marisam2019/ECE411-roomies/ECE 411 - Gantt Chart - Team 8.pdf

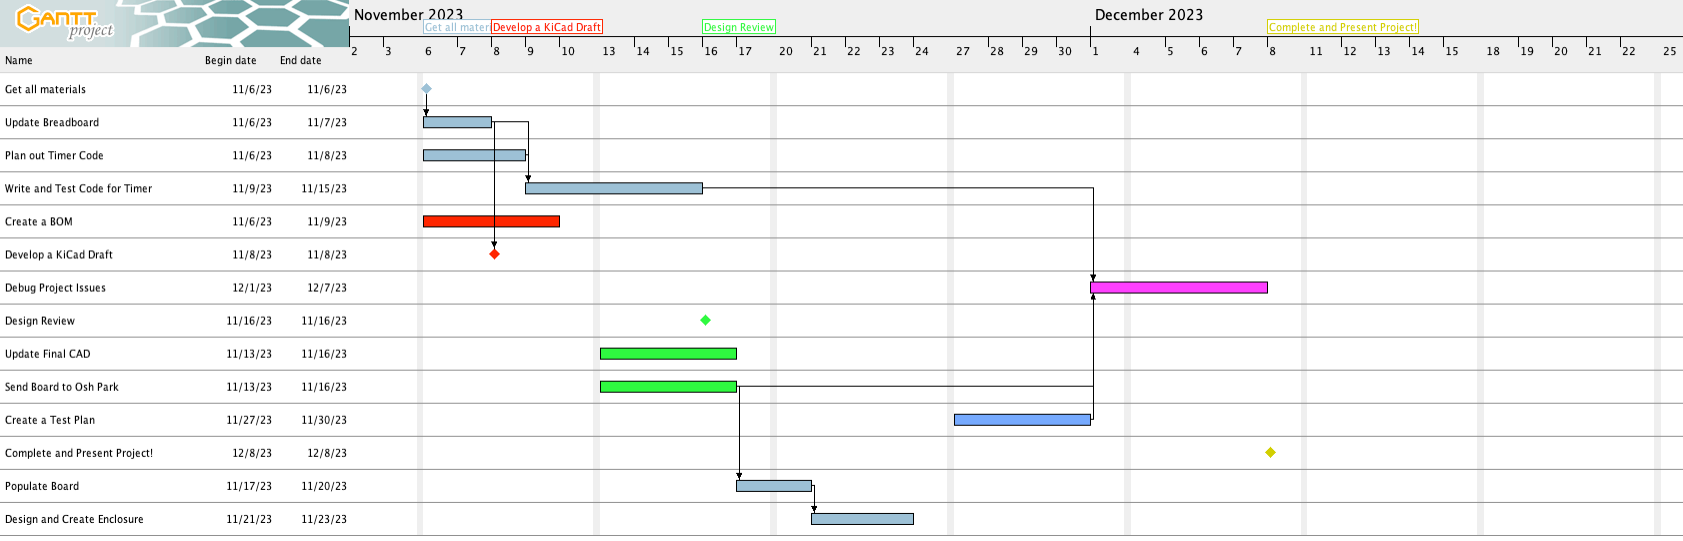
[picture p2: figure]
