marisam2019/ECE411-roomies/9-3.3 voltage divider.png

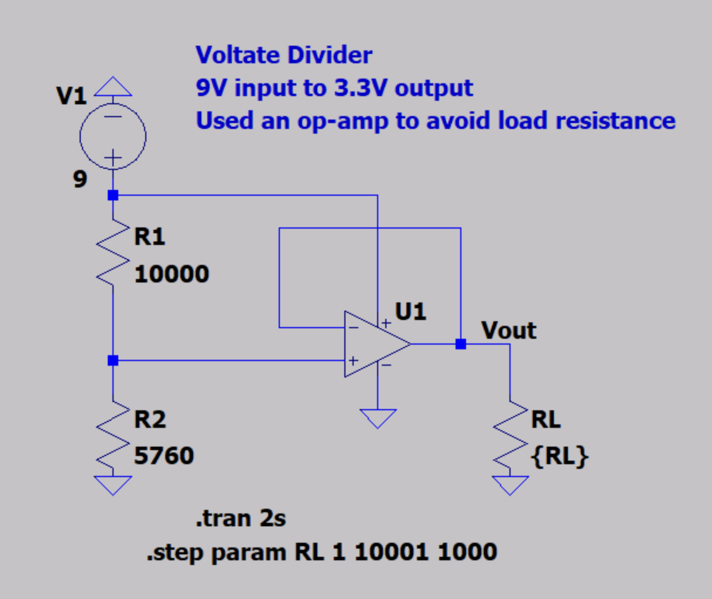
9-3.3 voltage divider.png
