marisam2019/ECE411-roomies/ECE 411 Bill of Materials - Team 8.xlsx

Bill Of Materials for: [TEAM 8] [The Roomies]
Last modified: [11/8/23]
PCB version: [PCB VERSION # 1]
BOM revision: [BOM REVISION #1] |  | P/NP | = Place/Not Place (components marked NP are not stuffed on the board)
Cnt | Part References | P/NP | Mfg | Mfg PN | Description | Dist | Dist Part Number | Cost Ea. | Cost Total
1 | A1 | P | Adafruit Industries LLC | 5477 | Adafruit HUZZAH32 - ESP32 Feather Board | DigiKey | 1528-5477-ND | $22.50 | $22.50
1 | Dis1 | NP | Adafruit Industries LLC | 1002 | Adafruit 0.56" 4-Digit 7-Segment Display w/I2C Backpack - White - STEMMA QT / qwiic | Adafruit Industries LLC | 1002 | $12.95 | $12.95
1 | LinearReg1 | P | Diodes Incorporated | AZ1117IH-3.3TRG1 | ASM Voltage regulator | Digikey | AZ1117IH-3.3TRG1DICT-ND | $0.38 | $0.38
5 | SW2, SW3, SW4, SW5, SW6 | P | Omron Electronics Inc-EMC Div | B3F-1070 | Push Switch | Digikey | SW406-ND | 0.44 | $2.20
1 | D1 | P | Kingbright | WP132XSURDK | 3mm LED Red | Digikey | 754-WP132XSURDK-ND | 0.39 | $0.39
1 | D2 | P | Kingbright | WP132XSYDK | 3mm LED Yellow | Digikey | 754-WP132XSYDK-ND | 0.41 | $0.41
1 | D3 | P | Kingbright | WP132XCGDK | 3mm LED Green | Digikey | 754-WP132XCGDK-ND | 0.39 | $0.39
1 | C1 | P | Nichicon | UKL1H100KDDANATD | CAP ALUM 10UF 20% 50V RADIAL | Digikey | 493-16315-1-ND | 0.34 | $0.34
1 | C2 | P | Murata Electronics | GCJ188R91H104KA01D | CAP CER 0.1UF 50V X8R 0603 | Digikey | 490-14412-1-ND | 0.21 | $0.21
1 | 7SegDisplay1, Rocker_SW_SPST1 | P | Adam Tech | PH1-08-UA | CONN HEADER VERT 8POS 2.54MM | Digikey | 2057-PH1-08-UA-ND | 0.18 | $0.18
1 | BZ1 | P | TDK Corporation | PS1440P02BT | Buzzers Transducer, Externally Driven Piezo 3 V 4kHz 75dB @ 3V, 10cm Through Hole | Digikey | 445-5242-1-ND | 0.78 | $0.78
 |  |  |  |  |  |  |  | TOTAL: | $40.73
VERSION INFO
Rev | Date | Notes
1.0r0 | 2023-11-08 | Initial BOM. Not everything chosen and implemented just yet, lots of things that need to be changed.
