marisam2019/ECE411-roomies/ECE 411 - Updated Schematic - Team8.pdf

## ESP32 Feather

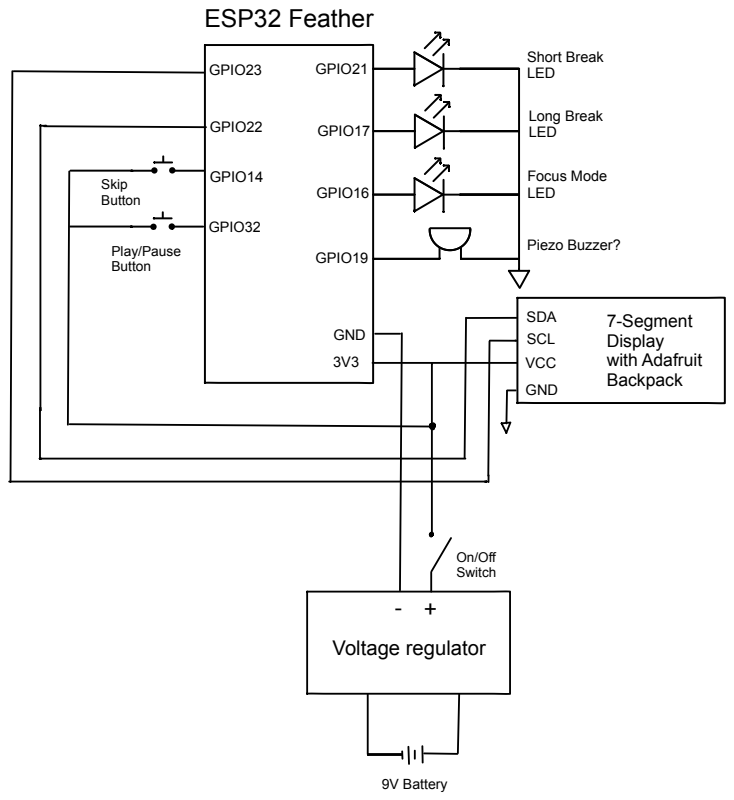
[picture p4: page 1]
9V Battery; On/Off Switch; Play/Pause Button; Skip Button; GPIO23; GPIO21; GND; Short Break LED; Long Break LED; Focus Mode LED; Piezo Buzzer?; GPIO16; GPIO19; GPIO22; VCC; SCL; SDA; GPIO17; 7-Segment Display with Adafruit Backpack; Voltage regulator; GPIO14; GPIO32
