marisam2019/ECE411-roomies/ECE 411 - Schematic - Group 8.pdf

# ESP32

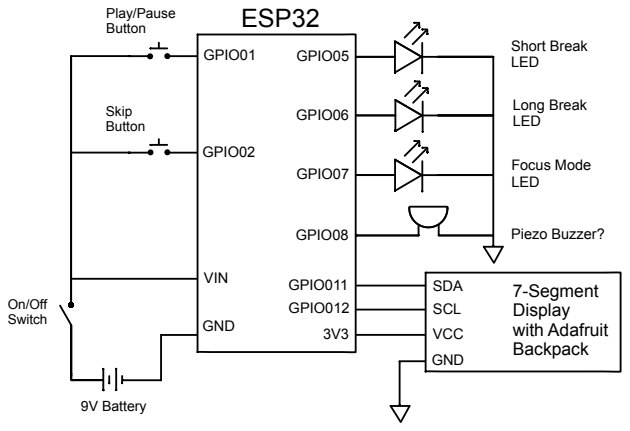
[picture p5: page 1]
9V Battery; On/Off Switch; Play/Pause Button; Skip Button; GPIO01; GPIO02; VIN; GND; Short Break LED; Long Break LED; Focus Mode LED; Piezo Buzzer?; GPIO05; GPIO06; GPIO07; GPIO08; VCC; SCL; GPIO011; SDA; GPIO012; 7-Segment Display with Adafruit Backpack
