marisam2019/ECE411-roomies/Pomodoro_Final_Schematic.pdf

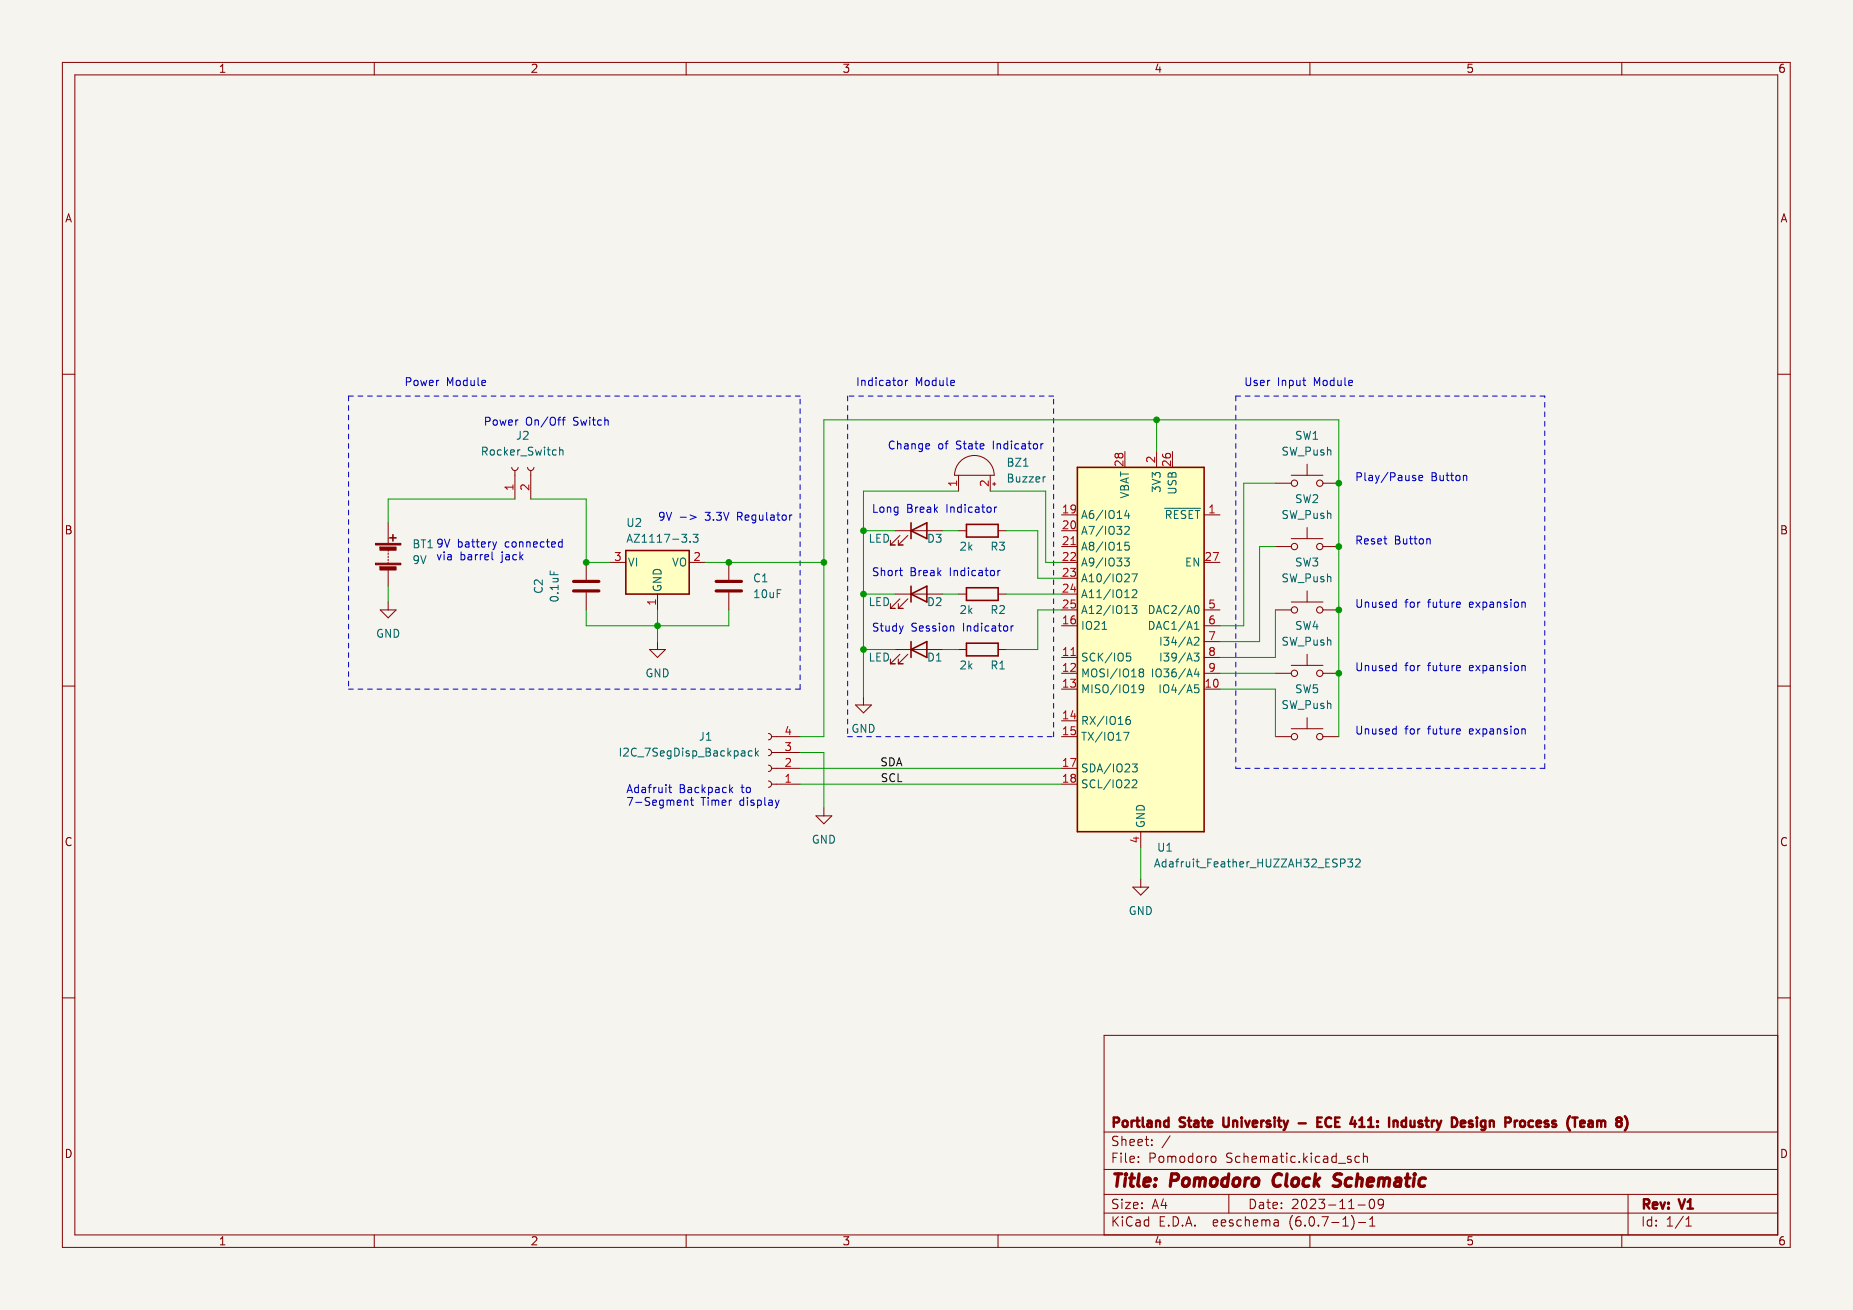
[picture p6: page 1]
