marisam2019/ECE411-roomies/Pomodoro Clock Schematic.pdf

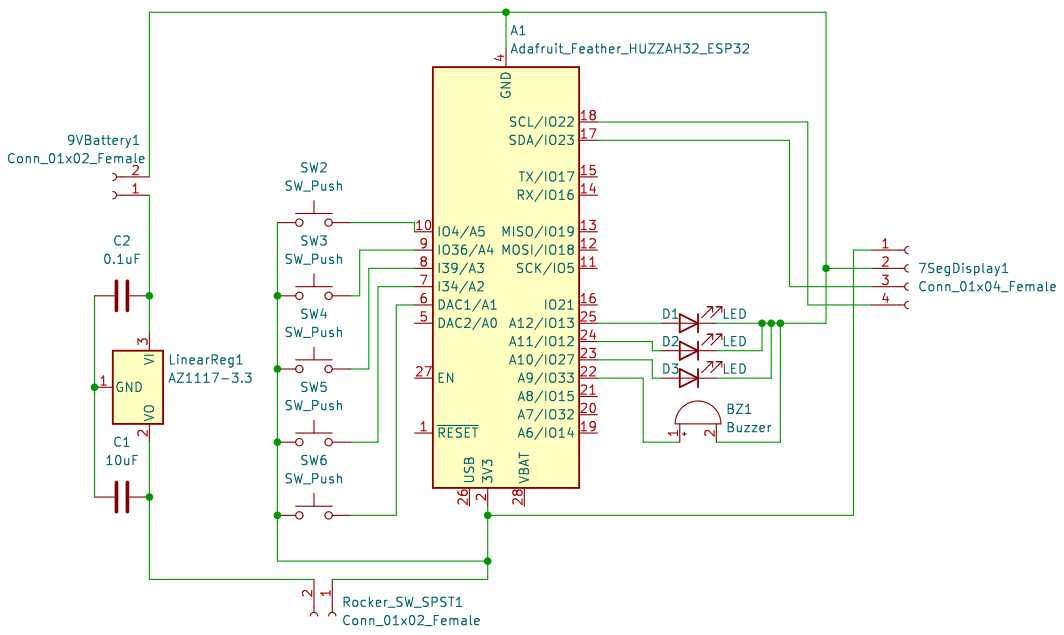
[picture p7: page 1]
