marisam2019/ECE411-roomies/Pomodoro_Final_Board_Layout.pdf

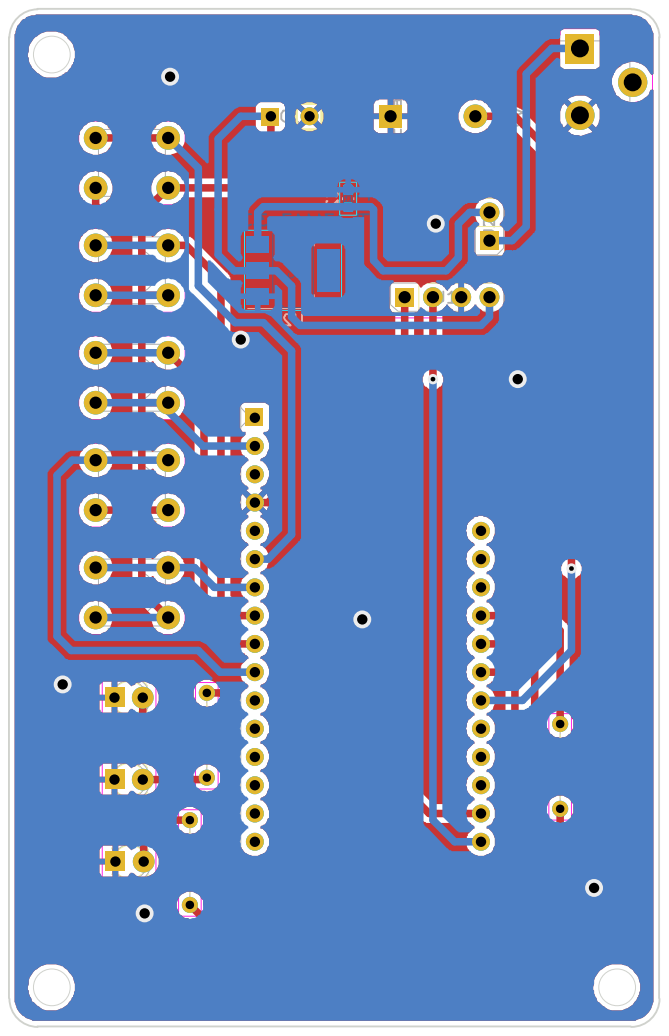
[picture p8: page 1]
