marisam2019/ECE411-roomies/Pomodoro Clock Board Layout.pdf

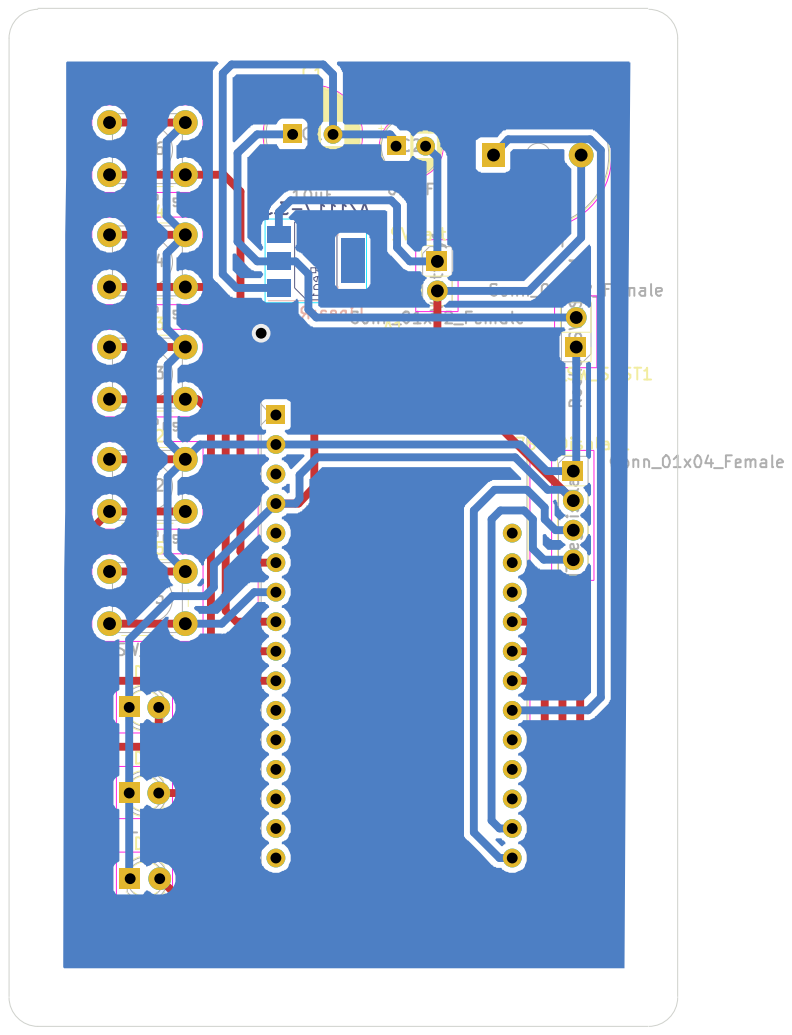
[picture p9: page 1]
