marisam2019/ECE411-roomies/Pomodoro Schematic.kicad_pcb

## KiCad design Pomodoro Schematic.kicad_pcb (2023-11-16)

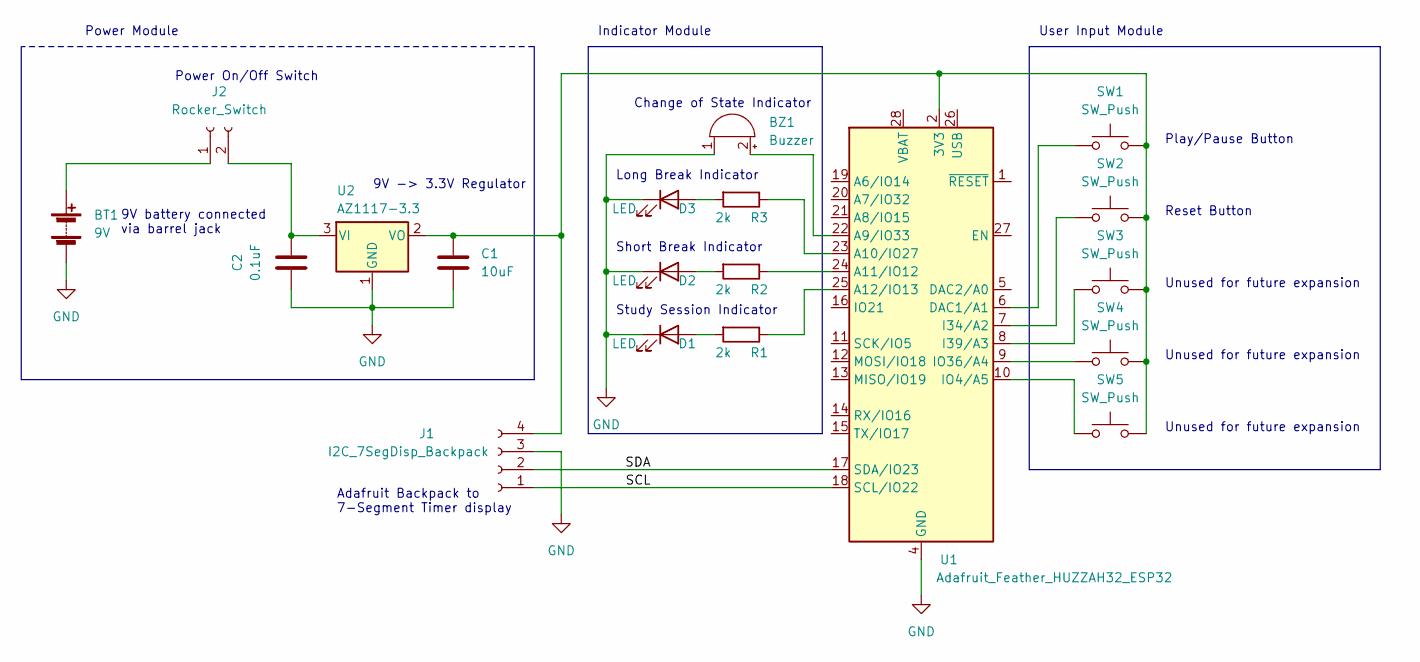
[picture p10: schematic Pomodoro Schematic.kicad_sch, Pomodoro Clock Schematic]

Parts:
BT1: 9V; BarrelJack_CUI_PJ-102AH_Horizontal
BZ1: Buzzer; Buzzer_12x9.5RM7.6
C1: 10uF; CP_Radial_D8.0mm_P3.50mm
C2: 0.1uF; C_0603_1608Metric
D1, D2, D3: LED; LED_D3.0mm
J1: I2C_7SegDisp_Backpack; PinHeader_1x04_P2.54mm_Vertical
J2: Rocker_Switch; PinHeader_1x02_P2.54mm_Vertical
R1, R2, R3: 2k; R_Axial_DIN0204_L3.6mm_D1.6mm_P7.62mm_Horizontal
SW1, SW2, SW3, SW4, SW5: SW_Push; SW_PUSH_6mm
U1: Adafruit_Feather_HUZZAH32_ESP32; Adafruit_Feather
U2: AZ1117-3.3; SOT-223

Connections:
/SCL: J1.1, U1.18 (SCL/IO22)
/SDA: J1.2, U1.17 (SDA/IO23)
GND: BT1.2 (-), BZ1.1 (-), C1.2, C2.1, D1.1 (K), D2.1 (K), D3.1 (K), J1.3, U1.4 (GND), U2.1 (GND)
unnamed: C2.2, J2.2, U2.3 (VI)
unnamed: D1.2 (A), R1.2
unnamed: D2.2 (A), R2.2
unnamed: D3.2 (A), R3.2
unnamed: BT1.1 (+), J2.1
unnamed: R2.1, U1.24 (A11/IO12)
unnamed: C1.1, J1.4, SW1.2, SW2.2, SW3.2, SW4.2, SW5.2, U1.2 (3V3), U2.2 (VO)
unnamed: SW1.1, U1.6 (DAC1/A1)
unnamed: SW2.1, U1.7 (I34/A2)
unnamed: SW3.1, U1.8 (I39/A3)
unnamed: SW4.1, U1.9 (IO36/A4)
unnamed: SW5.1, U1.10 (IO4/A5)
unnamed: BZ1.2 (+), U1.22 (A9/IO33)
unnamed: R3.1, U1.23 (A10/IO27)
unnamed: R1.1, U1.25 (A12/IO13)

Notes on the sheet:
Unused for future expansion
9V battery connected via barrel jack
Adafruit Backpack to 7-Segment Timer display
Long Break Indicator
Study Session Indicator
Power Module
Indicator Module
User Input Module
Play/Pause Button
Reset Button
Short Break Indicator
Power On/Off Switch
9V -> 3.3V Regulator
Change of State Indicator

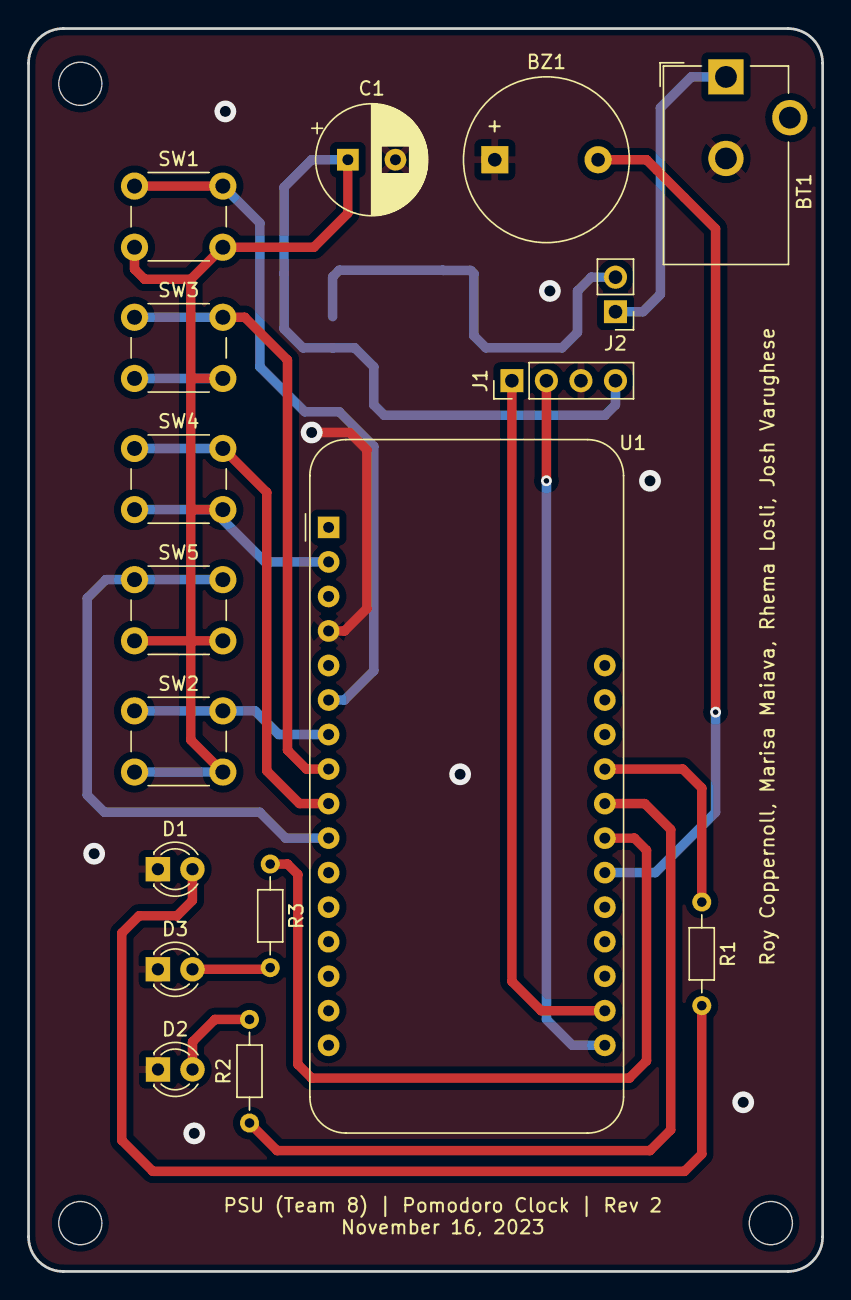
[picture p11: board Pomodoro Schematic.kicad_pcb from above]

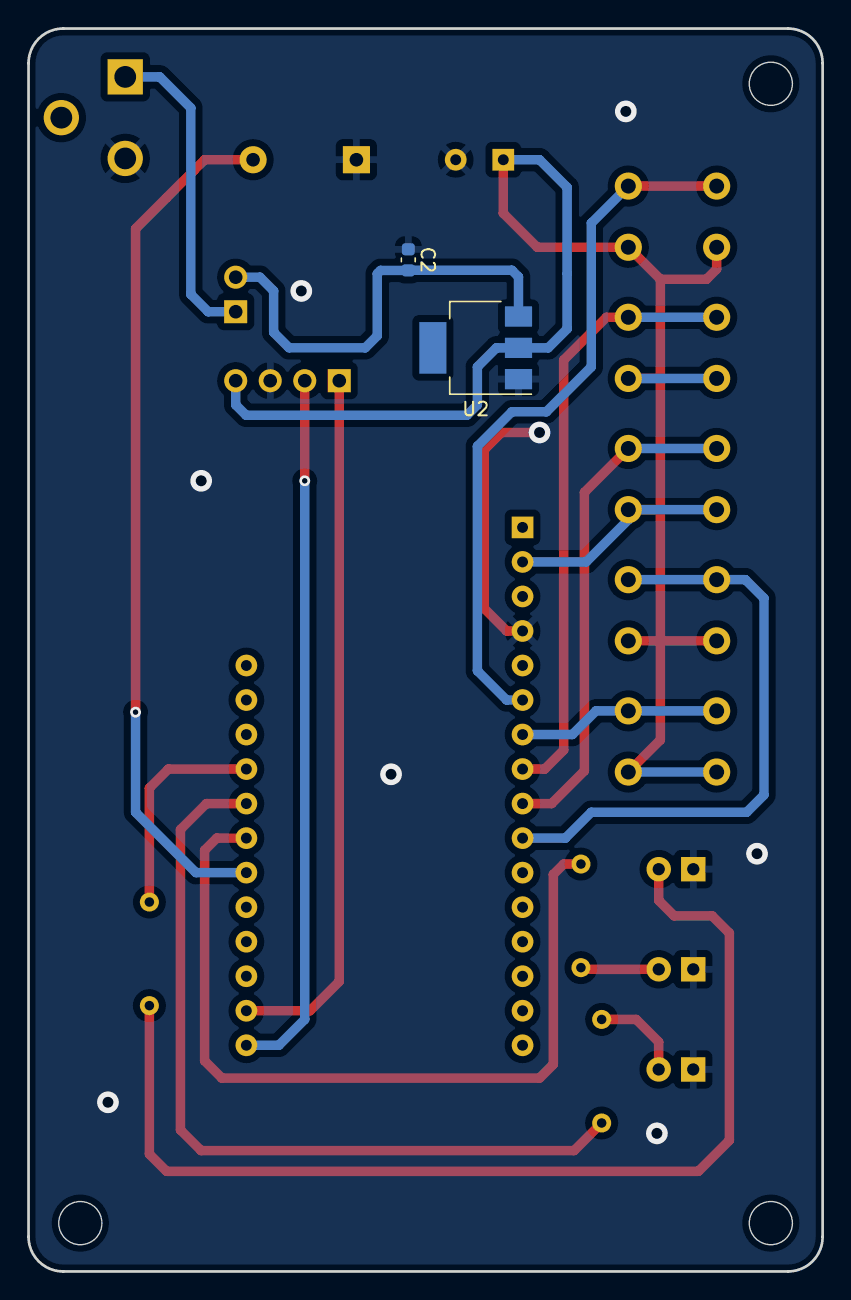
[picture p12: board Pomodoro Schematic.kicad_pcb from below]

Board: 2 copper layers, 58.4 x 91.4 mm, 19 parts (2 on the bottom side), 18 nets.
