marisam2019/ECE411-roomies/(commit log)

2023-11-02 Add files via upload
    Status Report:
    Team 8 is waiting on the multiplexer for the 7-segment display to arrive. Once that gets here, we can create the countdown timer. In the meantime, we will write pseudo-code for the entire project and Arduino code for the other features we can get working without the display. So far, we know how to get input from a button and output to the LEDs, 7-segment display, and piezo buzzer.
2023-11-08 Add files via upload
    Voltage divider that takes 9V input and delivers 3.29V output. A non-inverting op-amp with unity gain is added so that the load resistance does not effect the voltage divider.
2023-12-02 Add files via upload
    test arduino code to test functionality of the LEDs, buttons, and 7-segment display.
2023-12-06 Add files via upload
    Updated code as Dec 5. Attempts to incorporate functions to implement the timer modes. Currently goes through only the first function and then displays --.-- on the display.
2023-12-07 Team 8 - Test Plans (Test Case and Matrix Test
2023-12-07 Update WORKING_CODE.ino
    Changed program to use accurate timing (i.e 25 min, 5 min, 30 min for focus, short_break, long_break respectively).
    [WORKING_CODE.ino]
